BrantCarlson/CAERENet/README.md

CAERENet
========

Data processing, analysis, visualization, etc. for the Carthage Atmospheric Electricity Research and Education Network (CAERENet, see caerenet.org)
