BrantCarlson/CAERENet/pcb/adcsd_shield_pinout.png

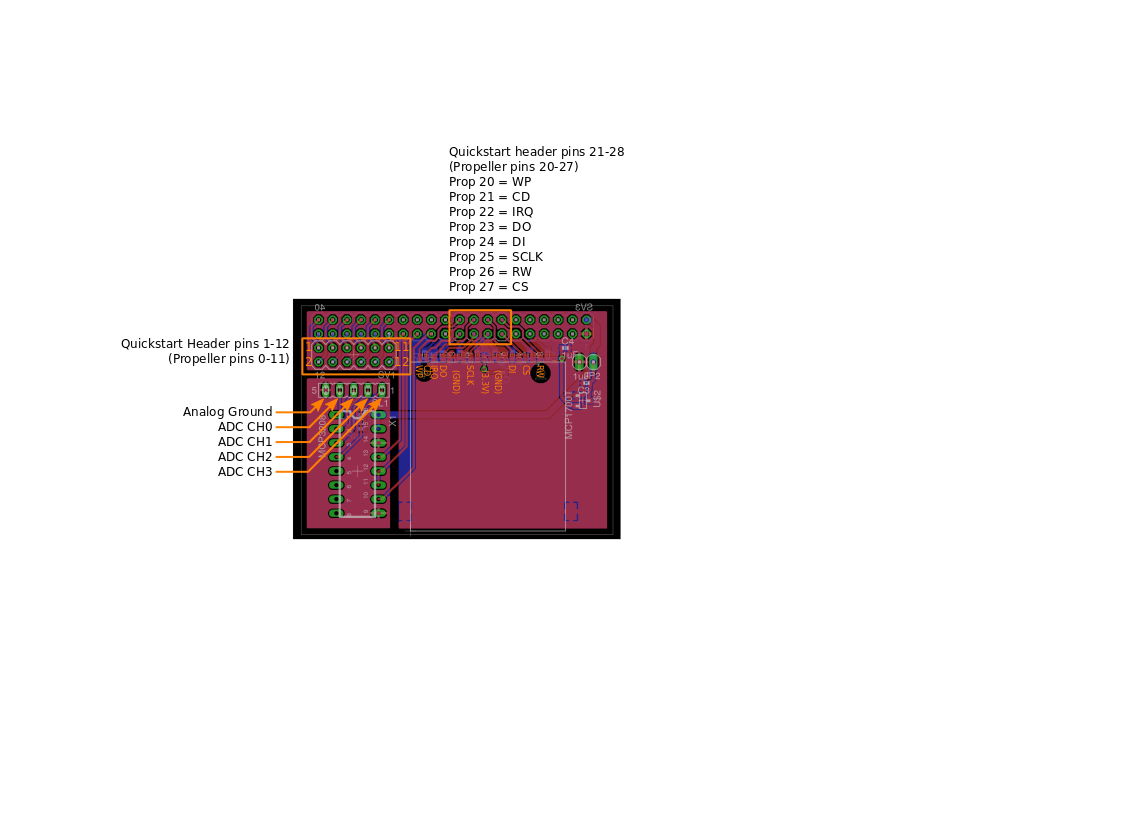
pcb/adcsd_shield_pinout.png
