BrantCarlson/CAERENet/instrument/3dprint/boxmount/boxmount.fcstd

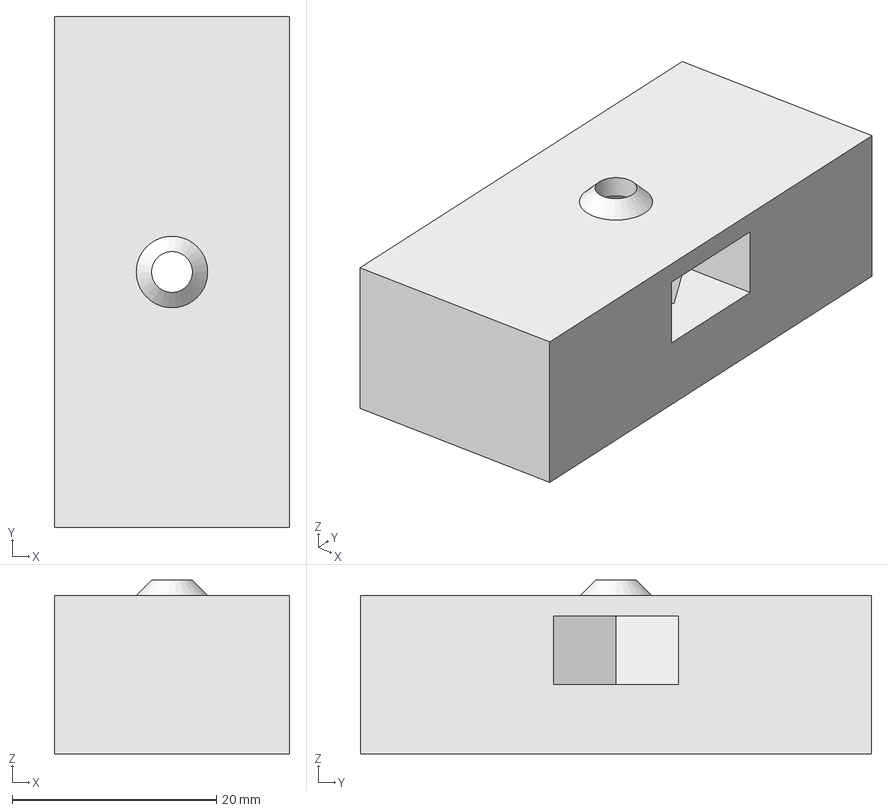
[picture p2: CAD file, 2015-07-31]
instrument/3dprint/boxmount/boxmount.fcstd
23.0 x 50.0 x 17.0 mm
