BrantCarlson/CAERENet/instrument/3dprint/electronics_mounts/clip_test.fcstd

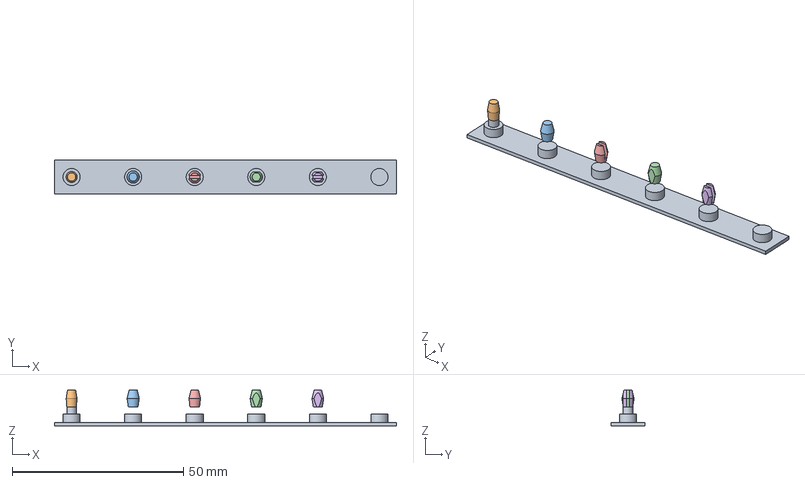
[picture p3: CAD file, 2015-07-07]
instrument/3dprint/electronics_mounts/clip_test.fcstd
100.0 x 10.0 x 10.5 mm
