BrantCarlson/CAERENet/instrument/3dprint/esc_clip/esc_clip.fcstd

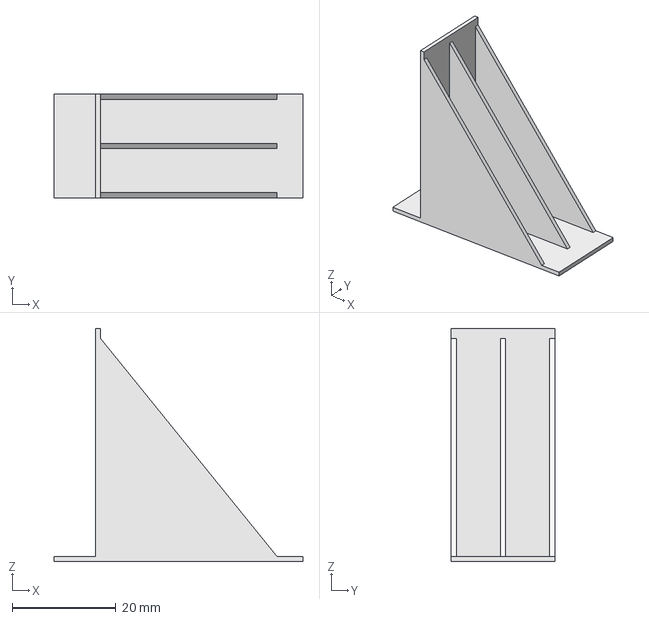
[picture p4: CAD file, 2015-07-14]
instrument/3dprint/esc_clip/esc_clip.fcstd
48.0 x 20.0 x 45.0 mm
