BrantCarlson/CAERENet/instrument/3dprint/motor_guard/motor_guard.stl

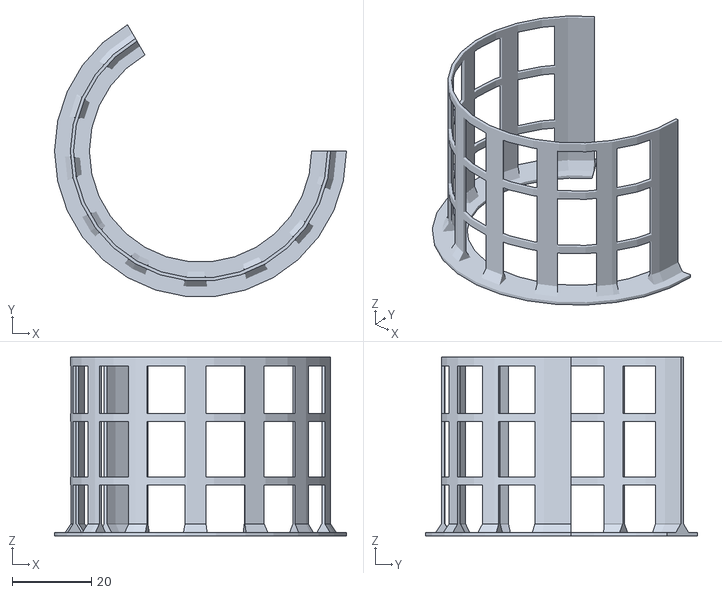
[picture p5: CAD file, 2015-07-20]
instrument/3dprint/motor_guard/motor_guard.stl
73.6 x 68.5 x 45.0
