BrantCarlson/CAERENet/instrument/3dprint/photogate/pgmount.fcstd

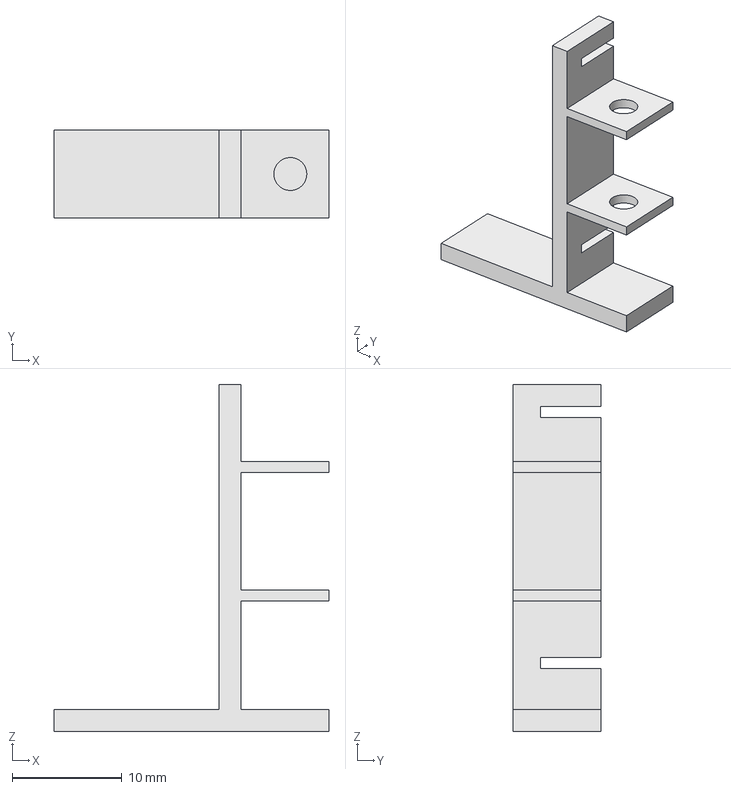
[picture p6: CAD file, 2015-07-09]
instrument/3dprint/photogate/pgmount.fcstd
25.0 x 8.00 x 31.6 mm
