BrantCarlson/CAERENet/instrument/3dprint/spacer/spacer_solid.FCStd

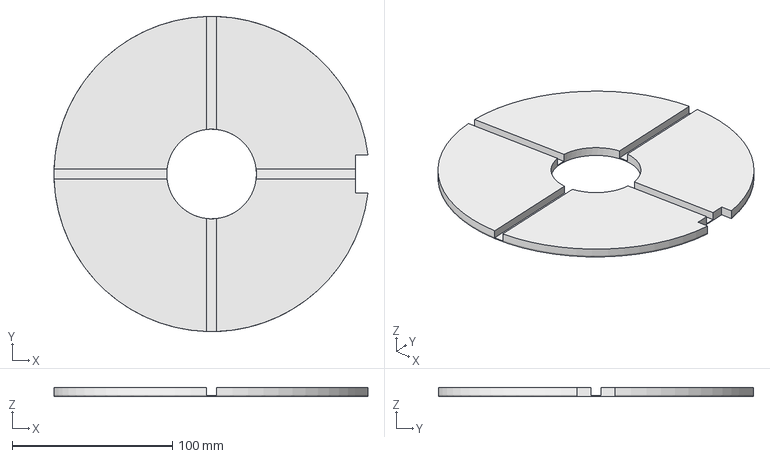
[picture p7: CAD file, 2015-07-07]
instrument/3dprint/spacer/spacer_solid.FCStd
196.1 x 196.8 x 5.60 mm
