BrantCarlson/CAERENet/instrument/3dprint/photogate/mring_19.0.stl

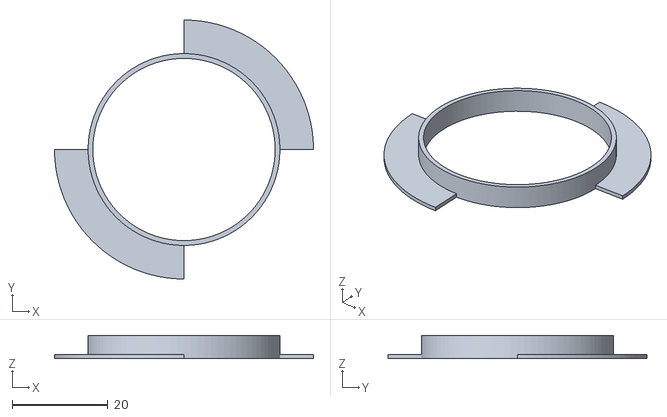
[picture p8: CAD file, 2015-07-07]
instrument/3dprint/photogate/mring_19.0.stl
54.0 x 54.0 x 4.80
