BrantCarlson/CAERENet/instrument/3dprint/spacer/spacer.FCStd

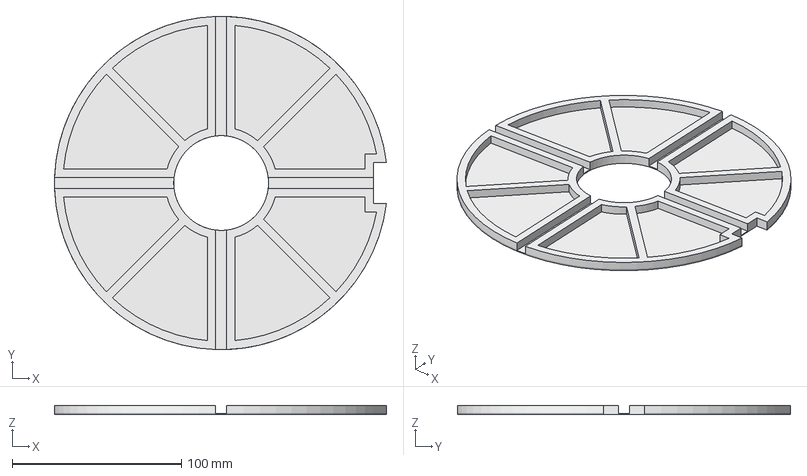
[picture p9: CAD file, 2015-07-07]
instrument/3dprint/spacer/spacer.FCStd
196.1 x 196.8 x 5.60 mm
