BrantCarlson/CAERENet/instrument/3dprint/photogate/mring_18.6.stl

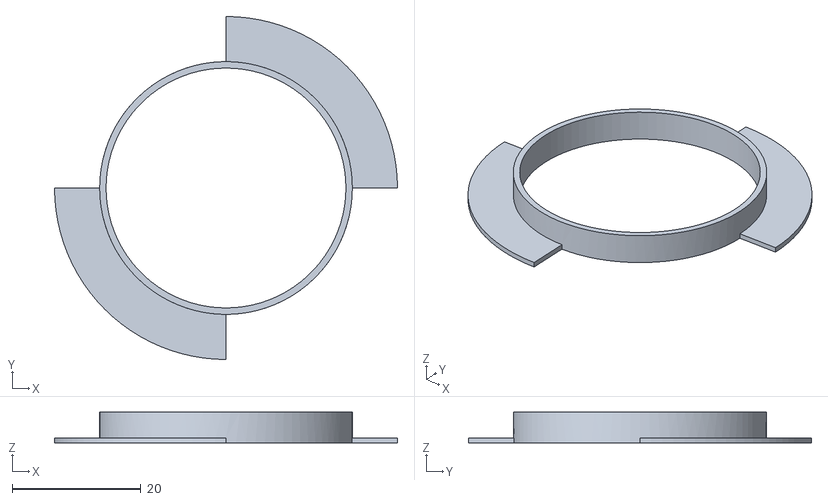
[picture p10: CAD file, 2015-07-07]
instrument/3dprint/photogate/mring_18.6.stl
53.2 x 53.2 x 4.80
