BrantCarlson/CAERENet/instrument/3dprint/spacer/spacer_pockets.stl

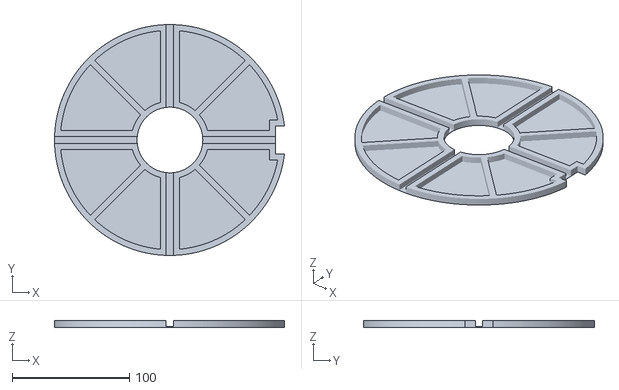
[picture p11: CAD file, 2015-07-07]
instrument/3dprint/spacer/spacer_pockets.stl
196.1 x 196.8 x 5.60
