BrantCarlson/CAERENet/instrument/3dprint/electronics_mounts/support_base_noclips.stl

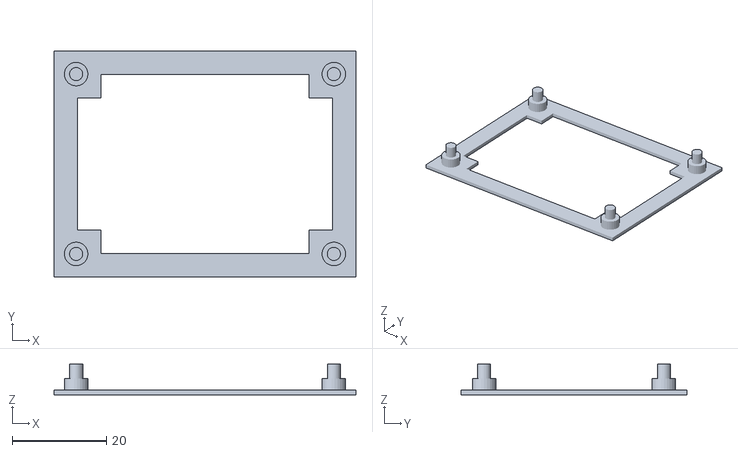
[picture p12: CAD file, 2015-07-07]
instrument/3dprint/electronics_mounts/support_base_noclips.stl
64.0 x 48.0 x 6.50
