BrantCarlson/CAERENet/instrument/3dprint/electronics_mounts/support_base_clips.stl

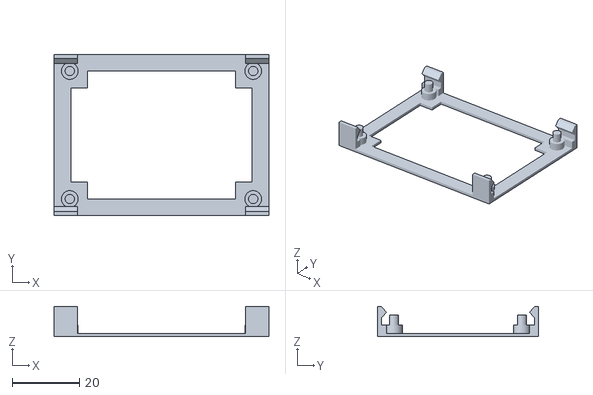
[picture p13: CAD file, 2015-07-07]
instrument/3dprint/electronics_mounts/support_base_clips.stl
64.0 x 48.0 x 9.00
