BrantCarlson/CAERENet/instrument/3dprint/photogate/mring_18.7.stl

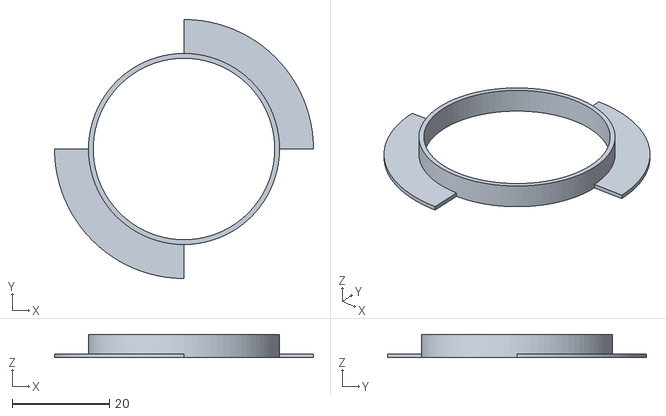
[picture p14: CAD file, 2015-07-07]
instrument/3dprint/photogate/mring_18.7.stl
53.4 x 53.4 x 4.80
