BrantCarlson/CAERENet/(list of files, cad)

Other CAD files:
instrument/3dprint/photogate/mring_18.5.stl
instrument/3dprint/photogate/mring_18.8.stl
instrument/3dprint/electronics_mounts/preamp_mount.fcstd
instrument/3dprint/photogate/mring.fcstd
instrument/3dprint/photogate/pgstand.stl
instrument/3dprint/photogate/mring_18.9.stl
instrument/3dprint/boxmount/boxmount.stl
instrument/3dprint/electronics_mounts/clip_test.stl
instrument/3dprint/electronics_mounts/preamp_mount_screws.fcstd
instrument/3dprint/electronics_mounts/prop_mount_screws.fcstd
instrument/3dprint/esc_clip/esc_clip.stl
instrument/3dprint/motor_guard/old/motor_guard.fcstd
instrument/3dprint/motor_guard/old/motor_guard.stl
instrument/3dprint/photogate/mring.stl
instrument/3dprint/spacer/spacer.stl
instrument/3dprint/spacer/spacer_solid.stl
