BrantCarlson/CAERENet/docs/wiring/quickstart_pin_finder.png

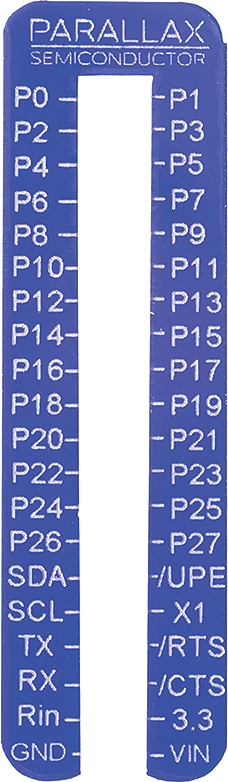
docs/wiring/quickstart_pin_finder.png
