BrantCarlson/CAERENet/pcb/preampSim.asc

C1: cap; 20pF
C2: cap; 20p; V=30 Rser=0 Lser=0
C3: cap; 10µ; V=25 Irms=8.06 Rser=0.00577565 Lser=0 mfg="KEMET" pn="C1210C106K3PAC" type="X5R"
C4: cap; 100n; V=16 Irms=1.94 Rser=0.0650466 Lser=0
C5: cap; 10n; V=25 Irms=134m Rser=1.77579 Lser=0
R1: res; 560k
R2: res; 560k
R3: res; 220
R4: res; 22k
R5: res; 1.19k
R6: res; 21.3k
U1: LT1097
U2: LT1028
U3: LT1097
V1: voltage; 10; Rser=0
V2: voltage; 10; Rser=0
V3: voltage; PULSE(-1 1 0 0.0125 0.0125 1e-12 0.025 10000); AC 1V
Named nets: 0, in, out1, vcc, vdd, out2
.tran 0 0.2 0.0
