BrantCarlson/CAERENet/pcb/preamp.brd

## EAGLE design pcb/preamp.brd (2015-07-29)

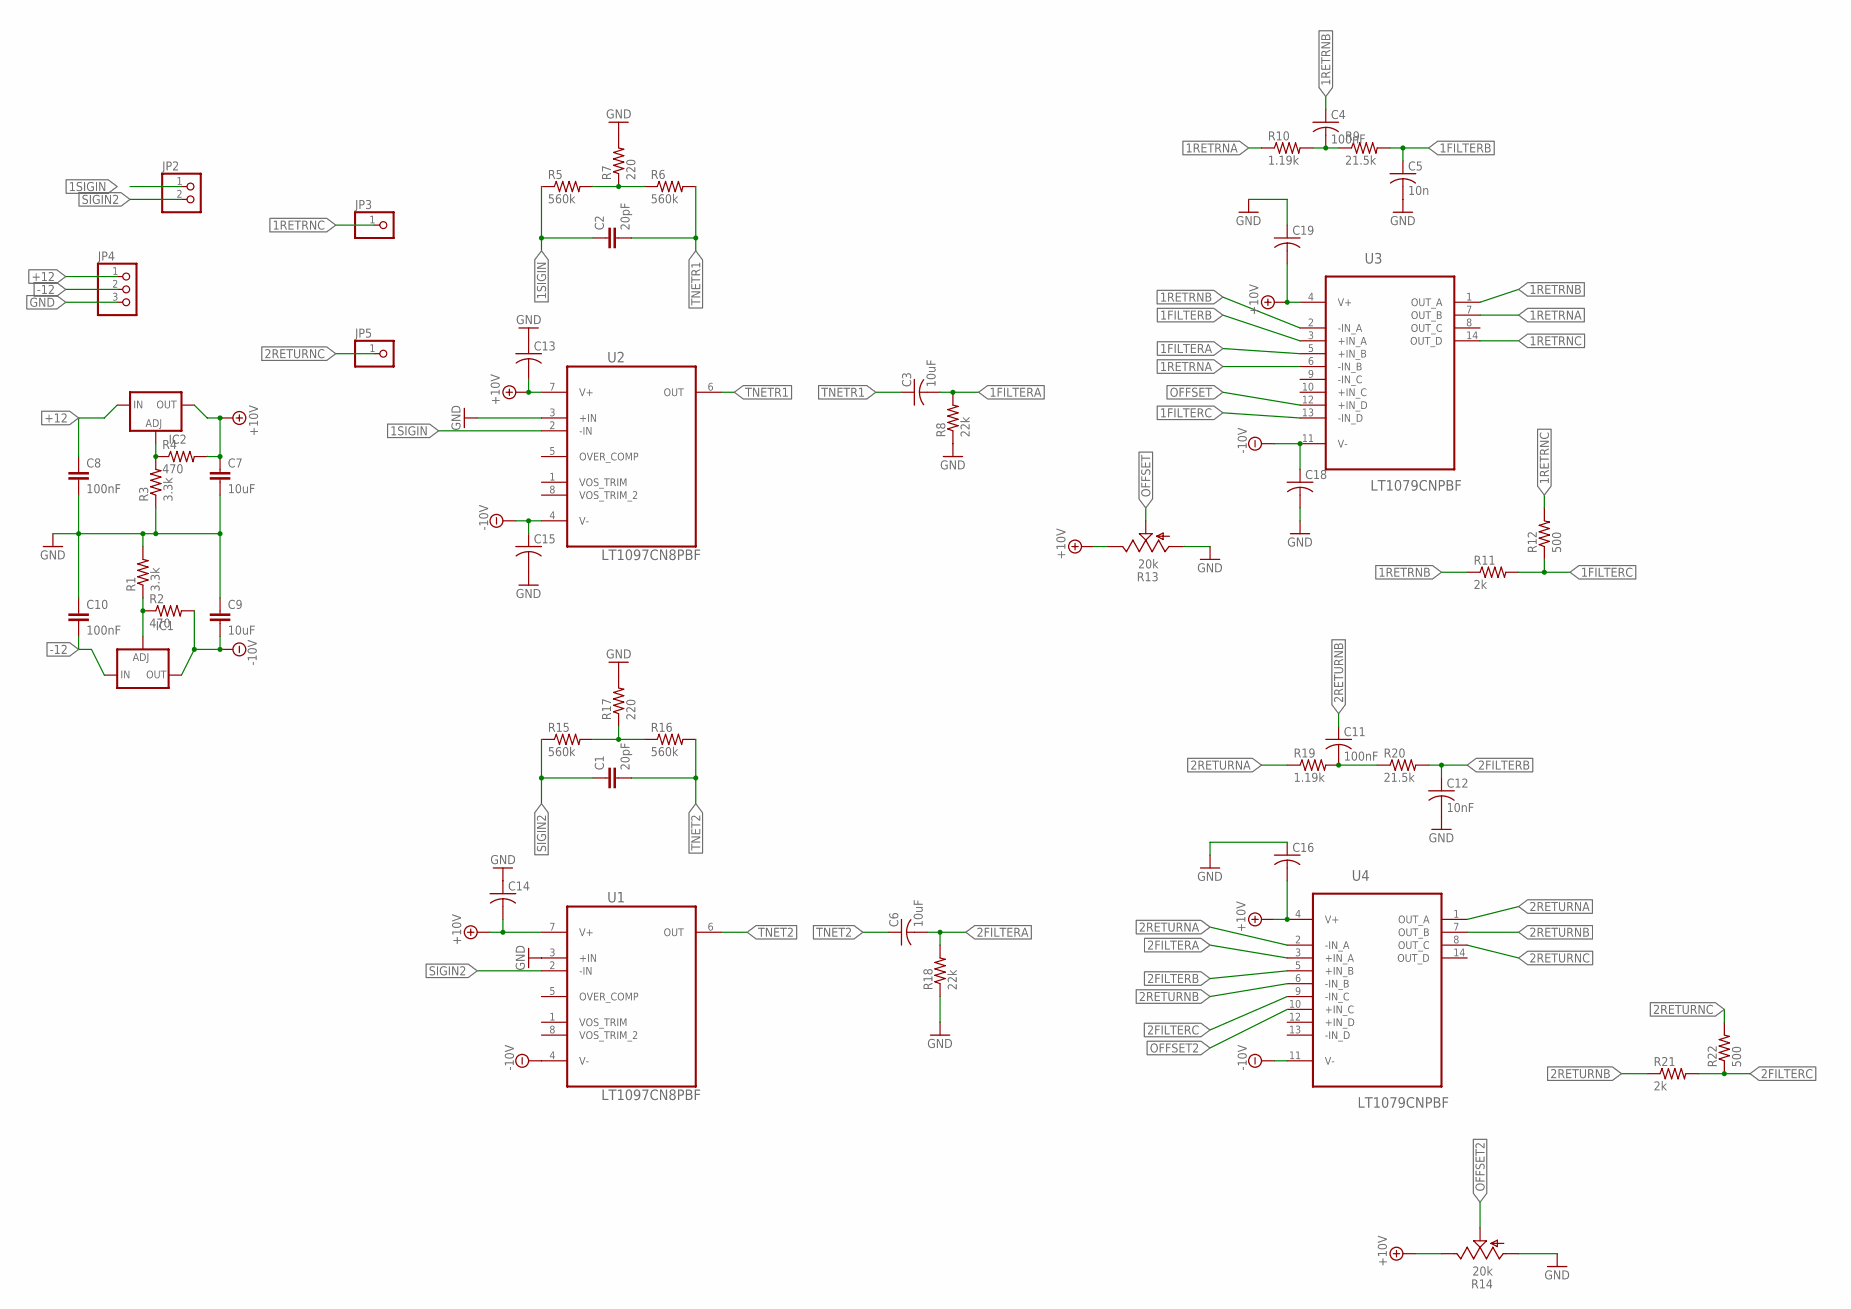
[picture p16: schematic preamp.sch]

Parts:
C1, C2: 20pF; C025-030X050
C3, C6: 10uF; C050-030X075
C4, C11: 100nF; C050-024X044
C5: 10n; C025-024X044
C7, C9: 10uF; C025-025X050
C8, C10: 100nF; C025-025X050
C12: 10nF; C025-024X044
C13, C14, C15, C16, C18, C19: C-US025-024X044; C025-024X044
IC1: LM337TS; 337TS
IC2: LM317TS; 317TS
JP2: PINHD-1X2; 1X02
JP3, JP5: PINHD-1X1; 1X01
JP4: PINHD-1X3; 1X03
R1, R3: 3.3k; 0204/5
R2, R4: 470; 0204/5
R5, R6, R15, R16: 560k; 0204/7
R7, R17: 220; 0204/7
R8, R18: 22k; 0204/5
R9, R20: 21.5k; 0204/5
R10, R19: 1.19k; 0204/5
R11, R21: 2k; 0204/5
R12, R22: 500; 0204/5
R13, R14: 20k; B64W
U1, U2: LT1097CN8PBF; DIP254P762X393-8
U3, U4: LT1079CNPBF; DIP254P762X394-14

Connections:
1FILTERA: C3.2, R8.2, U3.5 (+IN_B)
1FILTERB: C5.1, R9.2, U3.3 (+IN_A)
1FILTERC: R11.2, R12.1, U3.13 (-IN_D)
1RETRNA: R10.1, U3.6 (-IN_B), U3.7 (OUT_B)
1RETRNB: C4.1, R11.1, U3.1 (OUT_A), U3.2 (-IN_A)
1RETRNC: JP3.1, R12.2, U3.14 (OUT_D)
1SIGIN: C2.1, JP2.1, R5.1, U2.2 (-IN)
2FILTERA: C6.2, R18.2, U4.3 (+IN_A)
2FILTERB: C12.1, R20.2, U4.5 (+IN_B)
2FILTERC: R21.2, R22.1, U4.9 (-IN_C)
2RETURNA: R19.1, U4.1 (OUT_A), U4.2 (-IN_A)
2RETURNB: C11.1, R21.1, U4.6 (-IN_B), U4.7 (OUT_B)
2RETURNC: JP5.1, R22.2, U4.8 (OUT_C)
+10V: C7.1, C13.2, C14.2, C16.2, C19.2, IC2.2 (OUT), R4.2, R13.E, R14.E, U1.7 (V+), U2.7 (V+), U3.4 (V+), U4.4 (V+)
+12: C8.1, IC2.3 (IN), JP4.1
-10V: C9.2, C15.1, C18.1, IC1.3 (OUT), R2.2, U1.4 (V-), U2.4 (V-), U3.11 (V-), U4.11 (V-)
-12: C10.2, IC1.2 (IN), JP4.2
GND: C5.2, C7.2, C8.2, C9.1, C10.1, C12.2, C13.1, C14.1, C15.2, C16.1, C18.2, C19.1, JP4.3, R1.2, R3.1, R7.2, R8.1, R13.A, R14.A, R17.2, R18.1, U1.3 (+IN), U2.3 (+IN)
unnamed: IC2.1 (ADJ), R3.2, R4.1
unnamed: IC1.1 (ADJ), R1.1, R2.1
unnamed: R5.2, R6.1, R7.1
unnamed: C4.2, R9.1, R10.2
unnamed: R15.2, R16.1, R17.1
unnamed: C11.2, R19.2, R20.1
OFFSET: R13.S, U3.12 (+IN_D)
OFFSET2: R14.S, U4.10 (+IN_C)
SIGIN2: C1.1, JP2.2, R15.1, U1.2 (-IN)
TNET2: C1.2, C6.1, R16.2, U1.6 (OUT)
TNETR1: C2.2, C3.1, R6.2, U2.6 (OUT)

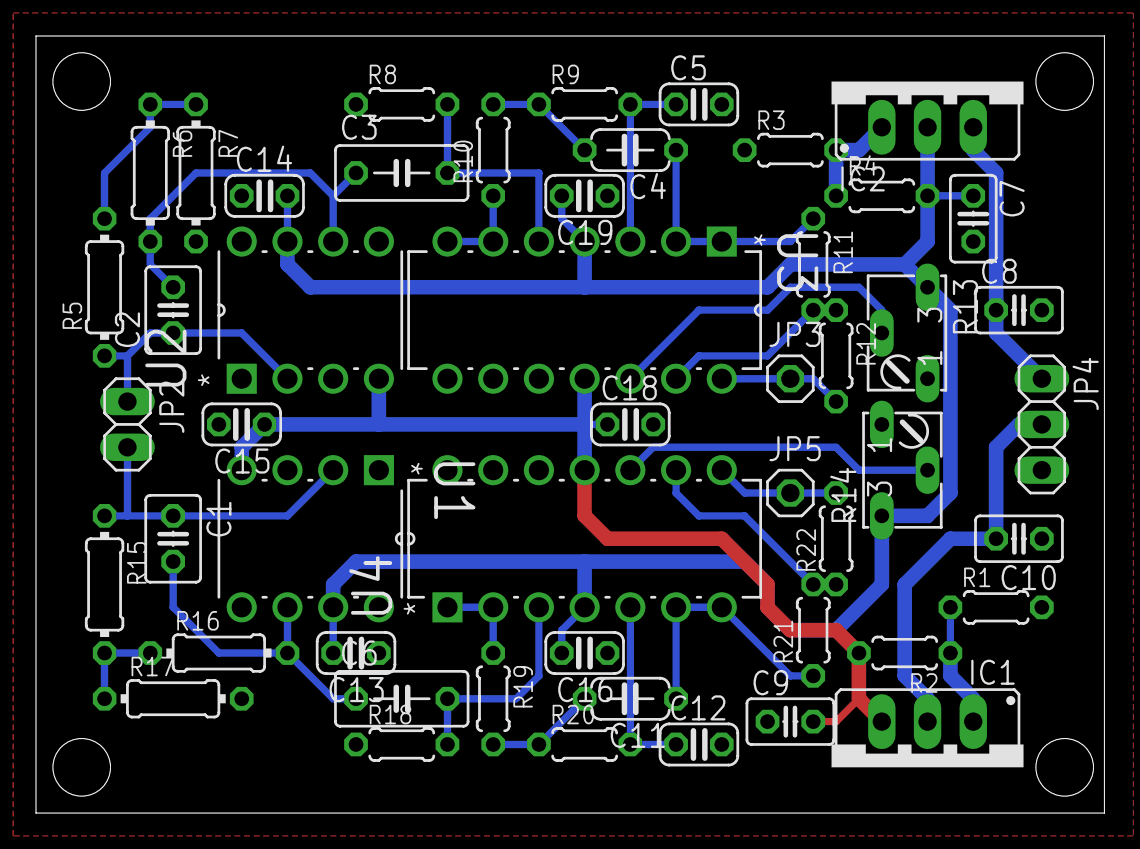
[picture p17: board preamp.brd from above]

Board: 2 copper layers, 59.4 x 43.2 mm, 50 parts (0 on the bottom side), 29 nets.
