BrantCarlson/CAERENet/pcb/adcsd_shield.brd

## EAGLE design pcb/adcsd_shield.brd (2015-07-29)

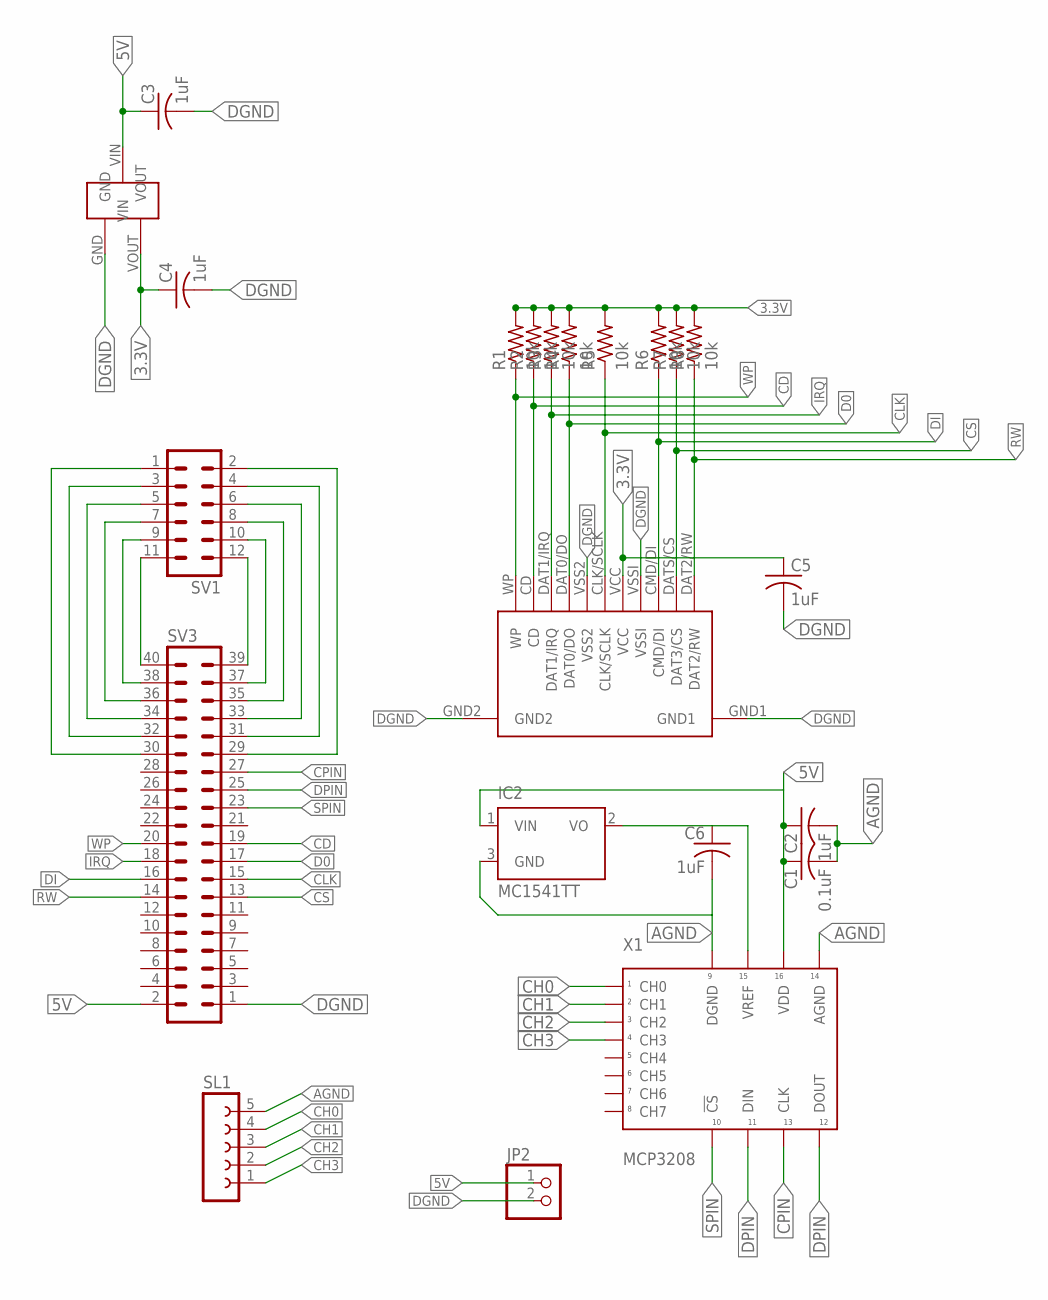
[picture p18: schematic adcsd_shield.sch]

Parts:
C1: 0.1uF; C0402
C2, C3, C4, C5, C6: 1uF; C0402
IC2: MC1541TT; SOT23
JP2: PINHD-1X2; 1X02
R1, R2, R3, R4, R5, R6, R7, R8: 10k; R0603
SL1: FE05-1
SV1: MA06-2
SV3: MA20-2
U$1: SD_1.0
U$2: MCP1700T; SOT23
X1: MCP3208; DIP16

Connections:
3.3V: C4.1, C5.1, R1.2, R2.2, R3.2, R4.2, R5.2, R6.2, R7.2, R8.2, U$1.VCC, U$2.VOUT
5V: C1.1, C2.1, C3.1, IC2.1 (VIN), JP2.1, SV3.2, U$2.VIN, X1.P$16 (VDD)
AGND: C1.2, C2.2, C6.2, IC2.3 (GND), SL1.5, X1.P$9 (DGND), X1.P$14 (AGND)
CD: R2.1, SV3.19, U$1.CD
CH0: SL1.4, X1.P$1 (CH0)
CH1: SL1.3, X1.P$2 (CH1)
CH2: SL1.2, X1.P$3 (CH2)
CH3: SL1.1, X1.P$4 (CH3)
CLK: R5.1, SV3.15, U$1.CLK/SCLK
CPIN: SV3.27, X1.P$13 (CLK)
CS: R7.1, SV3.13, U$1.DATS/CS (DAT3/CS)
D0: R4.1, SV3.17, U$1.DAT0/DO
DGND: C3.2, C4.2, C5.2, JP2.2, SV3.1, U$1.GND1, U$1.GND2, U$1.VSS2, U$1.VSSI, U$2.GND
DI: R6.1, SV3.16, U$1.CMD/DI
DPIN: SV3.25, X1.P$11 (DIN), X1.P$12 (DOUT)
IRQ: R3.1, SV3.18, U$1.DAT1/IRQ
unnamed: SV1.1, SV3.30
unnamed: SV1.3, SV3.32
unnamed: SV1.5, SV3.34
unnamed: SV1.2, SV3.29
unnamed: SV1.4, SV3.31
unnamed: SV1.6, SV3.33
unnamed: SV1.7, SV3.36
unnamed: SV1.9, SV3.38
unnamed: C6.1, IC2.2 (VO), X1.P$15 (VREF)
unnamed: SV1.11, SV3.40
unnamed: SV1.8, SV3.35
unnamed: SV1.10, SV3.37
unnamed: SV1.12, SV3.39
RW: R8.1, SV3.14, U$1.DAT2/RW
SPIN: SV3.23, X1.P$10 (!CS)
WP: R1.1, SV3.20, U$1.WP

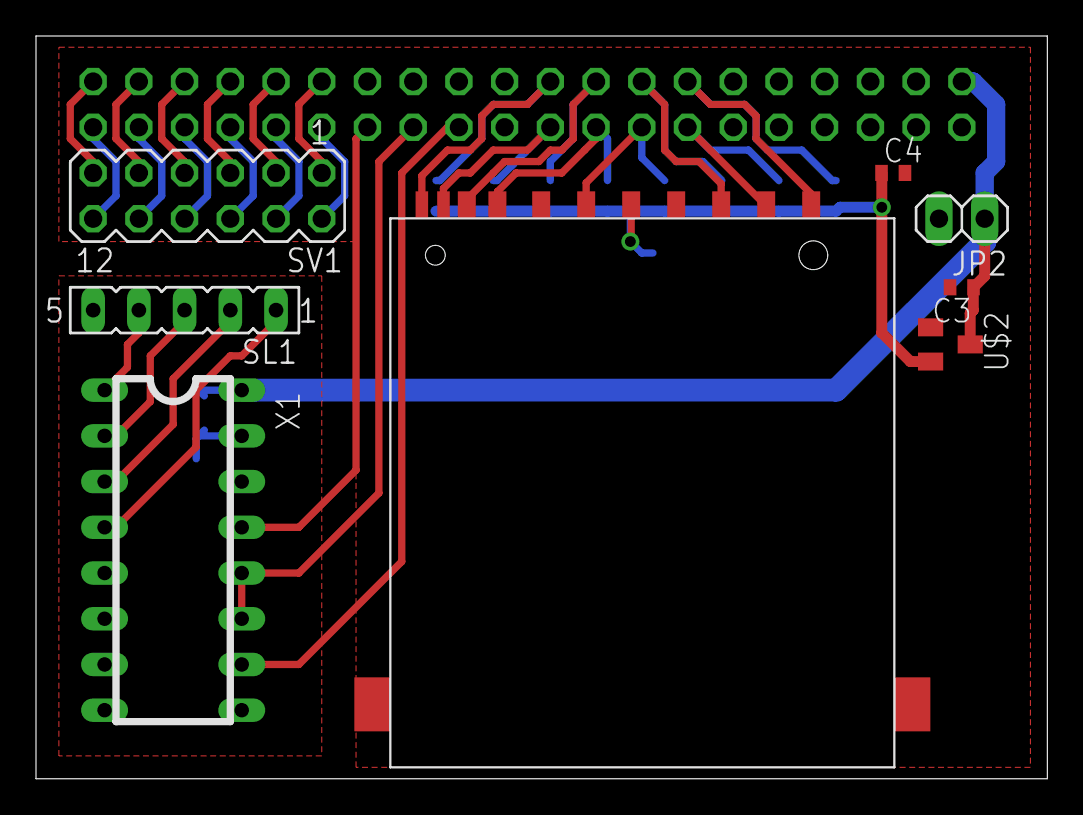
[picture p19: board adcsd_shield.brd from above]

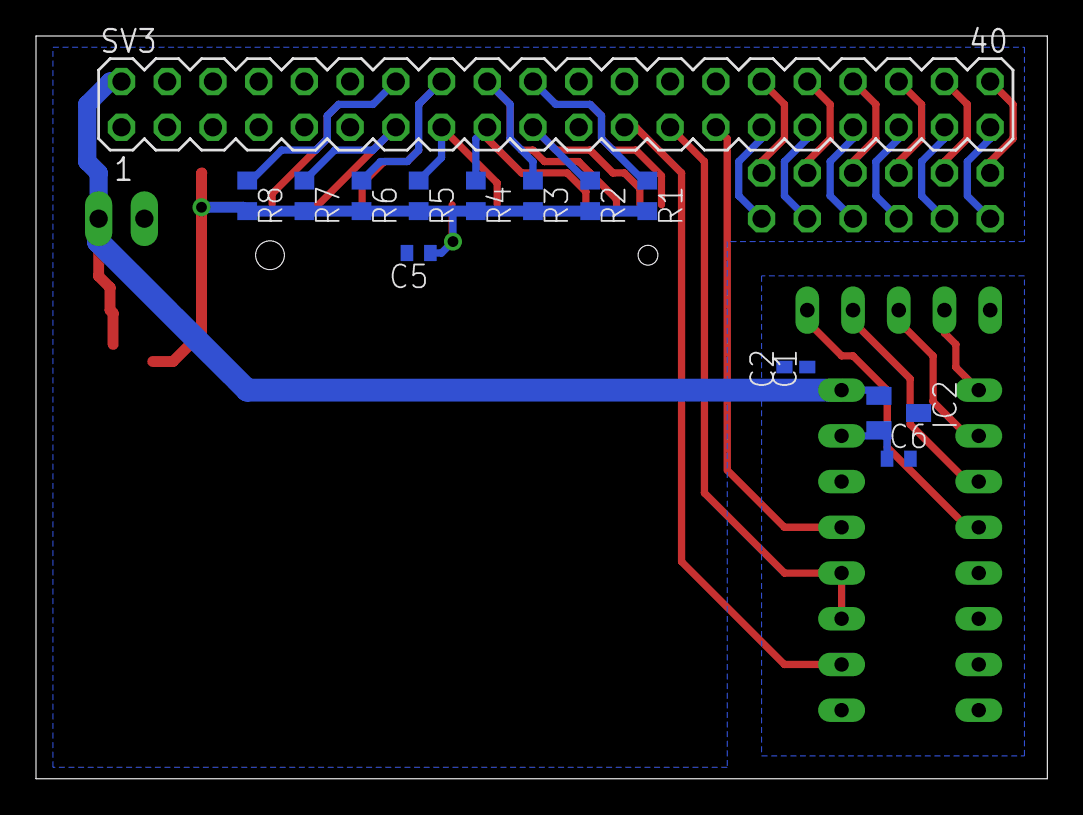
[picture p20: board adcsd_shield.brd from below]

Board: 2 copper layers, 56.2 x 41.3 mm, 22 parts (14 on the bottom side), 32 nets.
