BrantCarlson/CAERENet/rpi/ccode/pseudoSPI.c

#include <stdio.h>
#include <wiringPi.h>

// communications pins
// note that with wiringPi, these DO NOT correspond to the header on
// the physical RPi board.  Instead, the correspond to pins 11, 12, 13, and 15
// on the physical board.  See the output of the command "gpio readall" for details.
#define MCLK 0
#define SCLK 1
#define MOSI 2
#define MISO 3

void setup(){
  if(wiringPiSetup() == -1){
    printf("wiringPiSetup failed...?\n");
    exit(1);
  }

  pinMode(MCLK, OUTPUT);
  pinMode(SCLK, INPUT);
  pinMode(MOSI, OUTPUT);
  pinMode(MISO, INPUT);

  digitalWrite(MCLK,0);
}

void shutdown(){
  pinMode(MCLK, INPUT);
  pinMode(SCLK, INPUT);
  pinMode(MOSI, INPUT);
  pinMode(MISO, INPUT);
}

int io1(int send){
  int in;

  digitalWrite(MCLK,1);

  while(digitalRead(SCLK)==0){
    continue; // add a delay here?
    //delay(1); // 1 ms delay
  }

  digitalWrite(MOSI,send);
  digitalWrite(MCLK,0);

  while(digitalRead(SCLK)==1){
    continue; // add a delay here?
    //delay(1); // 1 ms delay
  }

  in = digitalRead(MISO);

  return in;
}

int io16(int send){
  int i=0;
  int in=0;
  
  for(i=0; i<16; ++i){
    in = in | (io1(send & 1) << i);
    send = send >> 1;
  }

  return in;
}

int main(void){
  int x;
  setup();

  while(true){
    printf("sending 1...\n");
    x = io1(1);
    printf("sent 1, got %d.\n",x);

    printf("sending 0...\n");
    x = io1(0);
    printf("sent 0, got %d.\n",x);
  }

  shutdown();

  return 0;
}
