BrantCarlson/CAERENet/rpi/ccode/test.c

/*
 * blink.c:
 *      blinks the first LED
 *      Gordon Henderson, projects@drogon.net
 */

#include <stdio.h>
#include <wiringPi.h>

int main (void)
{
  printf ("Raspberry Pi blink\n") ;

  if (wiringPiSetup () == -1)
    return 1 ;

  pinMode (0, OUTPUT) ;         // aka BCM_GPIO pin 17

  for (;;)
  {
    digitalWrite (0, 1) ;       // On
    delay (2000) ;               // mS
    digitalWrite (0, 0) ;       // Off
    delay (2000) ;
  }
  return 0 ;
}
