BrantCarlson/CAERENet/(commit log)

2014-06-01 adding initial drafts (unedited) from summer 2013
    ... and related work from fall 2013.
    note also .gitignore file to ignore .pyc files
    [Calibration.csv]
2014-06-10 adding spectrogram, power spectrum plotting code
2014-07-30 reorganizing and getting things uploaded to git
    [Calibration.csv]
2014-08-02 adding spin code on propeller
2014-08-09 fixing formatting, adding Makefile
    for use on linux with simpleIDE (for propeller-load) and the Brad's Spin
    Tool compiler (bstc.linux). YMMV -- check the paths in the Makefile.
    [safe_spi.spin]
2014-08-12 adding some C GPIO test code with wiringPi
2014-08-12 changing delay, fixing makefile
    test C GPIO code with wiringpi works...
    now to edit it to handle the pesudo-SPI...
    [test.c]
2014-08-12 adding pseudoSPI draft (probably buggy)
    untested
    [pseudoSPI.c]
2014-08-14 adding ADC/SD shield board and schematic to repo
    [adcsd_shield.brd, adcsd_shield.sch]
2014-08-14 adding preamp schematic and board layout to repo
    [preamp.brd, preamp.sch]
2014-08-14 adding ADC pinout document
2014-08-14 adding FSRW test code for ADC/SD shield
    will move to own directory later
2014-08-14 fixing pin numbers for main program
    [prop.spin]
2014-08-15 adding speed test wiringPi code
2014-08-15 adding python speed test, fixing pins in main code
    [pseudoSPI_speedtest.py, rpi.py]
2014-08-15 documenting speed test results
    see comments in pseudoSPI_speedtest.spin.
    the punchline: python on RPi isn't that much slower than C/wiringPi.
    I'm surprised.
2015-01-01 stripping down prop.spin for no-daq code.
2015-01-03 no-communications data collection
    seems to work with ADC/SD shield... be sure SD shield ADC part has
    proper ground.
    I also fried and ADC chip somehow in there.. not sure how.
2015-07-07 adding part drawings and 3d print files
    [clip_test.fcstd, clip_test.stl, mring.fcstd, mring.stl, mring_18.5.stl, mring_18.6.stl, mring_18.7.stl, mring_18.8.stl]
2015-07-07 starting to work out wiring details
2015-07-08 adding a bit of paranoia Re: ESC BEC power
2015-07-08 adding docs, starting more wiring documentation
2015-07-09 adding initial prototype design for esc holder, some updated docs
    [esc_clip.fcstd, esc_clip.stl]
2015-07-09 photogate mount slots go all the way to the edge now.
    [pgmount.fcstd]
2015-07-09 adding motor guard designs
    [motor_guard.fcstd, motor_guard.stl]
2015-07-09 updated wiring docs, adding some straggler files
2015-07-09 adding photogate power to pinout
2015-07-09 adding ideas Re: grounding
2015-07-14 some updates
    [esc_clip.fcstd, esc_clip.stl, motor_guard.fcstd, motor_guard.stl]
2015-07-17 working. sigh...
    propeller-load comes from simpleide
    you don't need the entire package, just the parts that deal with
    propeller-load, so... extract the .deb file (dpkg -x something.deb) and
    just call the propeller-load executable from whatever directory.
2015-07-17 ok, looks to be working, but ... no dice on the ESC.
    needs more power... will have to look into other power supplies.
2015-07-20 adding notes on how to deal with power supply issues
    also updating motor guard designs to be stronger
    [motor_guard.scad, motor_guard.stl]
2015-07-20 utility to help with ESC calibration
2015-07-20 adding notes Re: ESC calibration
2015-07-21 attempted fix of long cnt --> word buffer_1[0] issue
    probably doesn't work, needs to be checked.
    [prop.spin]
2015-07-21 adding code to properly incement filenames
    from
    http://forums.parallax.com/discussion/106345/can-the-propeller-support-string-variables-or-other-useful-string-operations
    September 8th 2008 post by Mike Green
    compiles, but untested.
2015-07-22 fixed overrun in data read code
    working on noise analysis
    [prop.spin]
2015-07-22 noise analysis done. now, to fix things...
    [prop.spin]
2015-07-23 bulk of noise is coming from power supply coupling
2015-07-24 updated noise analysis, going for long data collection
    [prop.spin]
2015-07-28 more noise debugging, some simulating
    [prop.spin]
2015-07-28 some circuit modifications, updates
    [adcsd_BoM.csv, adcsd_shield.brd, adcsd_shield.sch, preamp.brd, preamp.sch, preamp_BoM.csv]
2015-07-29 playing with simulation, updating component values accordingly
    decreasing distortion
    component values in the simulation are now more correct.
    [adcsd_shield.brd, preamp.brd, preamp.sch]
2015-07-29 updating schematic to reflect new component values
    [preamp.brd, preamp.sch]
2015-07-31 playing with data, designing box mount
    seems to print a bit too small.
    [boxmount.fcstd, boxmount.stl]
2015-07-31 increasing size of openings for nut in boxmount
    [boxmount.fcstd, boxmount.stl]
2015-07-31 increasing size of bolt hole to accomodate screw head
    [boxmount.fcstd, boxmount.stl]
2015-07-31 increasing size of box mount to better stabilize box
    started mucking aroud with julia
    [boxmount.fcstd, boxmount.stl]
